JustinRoyce/custom_kicad_lib/inkscape_kicad/kicad_image_layers/README.md

# Create Pyside6 
```
pyside6-uic kicad_image_layers.ui -o kicad_image_layers_pyside6.py
```
