JustinRoyce/custom_kicad_lib/inkscape_kicad/images/american_flag/american_flag_h1_w2_300ppi.png

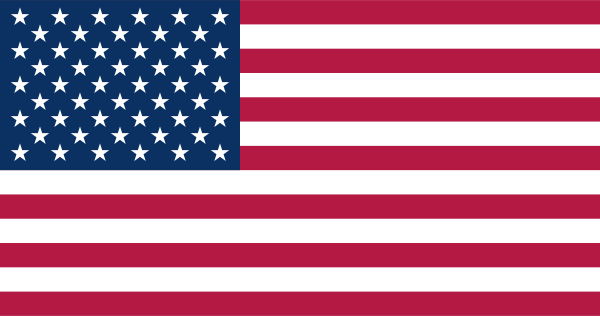
inkscape_kicad/images/american_flag/american_flag_h1_w2_300ppi.png
