JustinRoyce/custom_kicad_lib/mcad/Dorabo_Electric.3dshape/DB128L-5.08-2P-GN-S.step

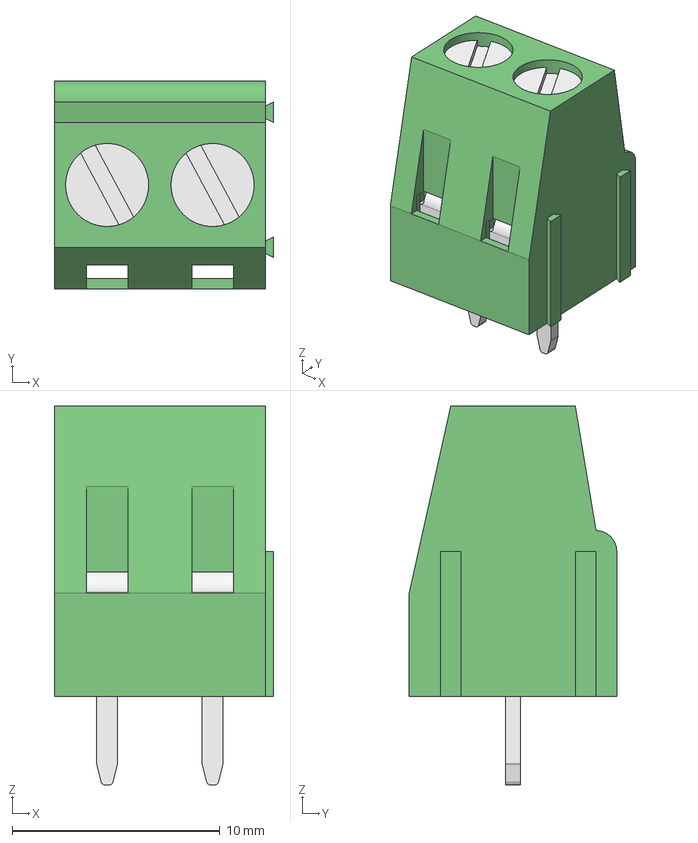
[picture p3: CAD file, 2025-11-29]
mcad/Dorabo_Electric.3dshape/DB128L-5.08-2P-GN-S.step
10.6 x 10.0 x 18.2 mm
Pin (1) (19)
Tornillo (1) (19)
Cubo interno (1) (19)
Pin (1) (1) (18)
Tornillo (1) (1) (18)
Cubo interno (1) (1) (18)
Pin (1) (11)
Tornillo (1) (11)
Cubo interno (1) (11)
Pin (1) (1) (10)
Tornillo (1) (1) (10)
Cubo interno (1) (1) (10)
