JustinRoyce/custom_kicad_lib/mcad/Dorabo_Electric.3dshape/DB125-2.54-2P-GN-S.step

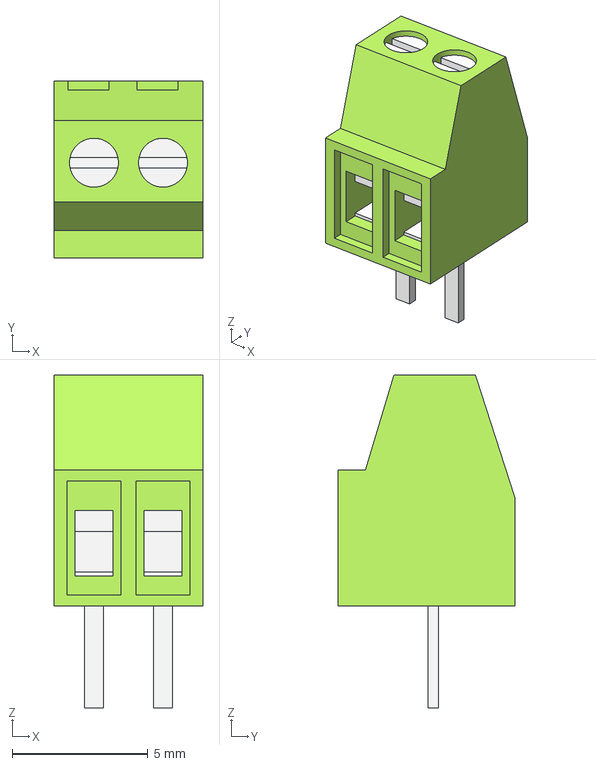
[picture p4: CAD file, 2025-11-29]
mcad/Dorabo_Electric.3dshape/DB125-2.54-2P-GN-S.step
5.48 x 6.50 x 12.3 mm
Housing
PlasticBody
